manuelilg/eeduro_delta/README.md

# eeduro_delta
A ROS package for the EEDURO Delta Roboter
