manuelilg/eeduro_delta/eeduro_delta_description/cad/fcinfo/base.csv

Info on the element
___________________
07/11/2017 13:07:57
Name of the document : | base_collision
Label Name : | Fusion001
Internal Name : | Fusion001
Name of the element : | Face15
Object type : | Compound
Mouse coordinates : | X: | -74.5734863281 | Y: | 17.348657608 | Z: | 20.0
Length of the object : | 1095.61944902 | mm
Perimeter of the shape : | 5948.85674713 | mm
Vertexes and details : | Edges : | 97 | Faces : | 38 | Vertexes faces : | 192 | Total : | 327
Edge1 | 23.5619445443 | mm | X1 | 86.4951954445 | Y1 | -61.4850740989 | Z1 | -3.97903932026e-13 | X2 | 73.5047992024 | Y2 | -53.9850654554 | Z2 | -2.68229882749e-13
Edge2 | 23.5619450726 | mm | X1 | 73.5047992024 | Y1 | -53.9850654554 | Z1 | -2.68229882749e-13 | X2 | 86.4951954445 | Y2 | -61.4850740989 | Z2 | -3.97903932026e-13
Edge3 | 23.5619449019 | mm | X1 | 86.4951878365 | Y1 | -61.4850697617 | Z1 | 14.0 | X2 | 73.5048067797 | Y2 | -53.9850697617 | Z2 | 14.0
Edge4 | 14.0 | mm | X1 | 86.4951878365 | Y1 | -61.4850697617 | Z1 | 14.0 | X2 | 86.4951954445 | Y2 | -61.4850740989 | Z2 | -3.97903932026e-13
Edge5 | 14.0 | mm | X1 | 73.5048067797 | Y1 | -53.9850697617 | Z1 | 14.0 | X2 | 73.5047992024 | Y2 | -53.9850654554 | Z2 | -2.68229882749e-13
Edge6 | 23.5619449019 | mm | X1 | 73.5048067797 | Y1 | -53.9850697617 | Z1 | 14.0 | X2 | 86.4951878365 | Y2 | -61.4850697617 | Z2 | 14.0
Edge7 | 200.0 | mm | X1 | -115.0 | Y1 | -70.235026919 | Z1 | 14.0 | X2 | -115.0 | Y2 | 129.764973081 | Z2 | 14.0
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
Matrix of inertia : | X: | 7448530703.95 | Y: | -59.306059444 | Z: | -40.7095603448 | : | 0.0
: | X: | -59.306059444 | Y: | 7605678914.8 | Z: | 606902711.949 | : | 0.0
: | X: | -40.7095603448 | Y: | 606902711.949 | Z: | 6841499590.22 | : | 0.0
: | X: | 0.0 | Y: | 0.0 | Z: | 0.0 | : | 1.0
