manuelilg/eeduro_delta/eeduro_delta_description/cad/fcinfo/oberarm/gewindestift_in_x.csv

Info on the element
___________________
07/08/2017 11:11:27
Name of the document : | Unnamed
Label Name : | Arm040
Internal Name : | Part__Feature
Name of the element : | Face7
Object type : | Solid
Mouse coordinates : | X: | -5.96392154694 | Y: | -0.510197639465 | Z: | 2.58369445801
Length of the object : | 3.90111069989 | mm
Perimeter of the shape : | 55.4406874623 | mm
Vertexes and details : | Edges : | 32 | Faces : | 15 | Vertexes faces : | 64 | Total : | 111
Edge1 | 3.92699081699 | mm | X1 | -6.3 | Y1 | -5.0270898555e-13 | Z1 | 1.75 | X2 | -6.3 | Y2 | -5.0270898555e-13 | Z2 | 4.25
Edge2 | 4.6 | mm | X1 | -1.7 | Y1 | -4.47641923529e-13 | Z1 | 1.75 | X2 | -6.3 | Y2 | -5.0270898555e-13 | Z2 | 1.75
Edge3 | 3.92699081699 | mm | X1 | -1.7 | Y1 | -4.47641923529e-13 | Z1 | 1.75 | X2 | -1.7 | Y2 | -4.47641923529e-13 | Z2 | 4.25
Edge4 | 4.6 | mm | X1 | -1.7 | Y1 | -4.47641923529e-13 | Z1 | 4.25 | X2 | -6.3 | Y2 | -5.0270898555e-13 | Z2 | 4.25
Edge5 | 3.92699081699 | mm | X1 | -6.3 | Y1 | -5.0270898555e-13 | Z1 | 4.25 | X2 | -6.3 | Y2 | -5.0270898555e-13 | Z2 | 1.75
Edge6 | 3.92699081699 | mm | X1 | -1.7 | Y1 | -4.47641923529e-13 | Z1 | 4.25 | X2 | -1.7 | Y2 | -4.47641923529e-13 | Z2 | 1.75
Edge7 | 3.29867228627 | mm | X1 | -1.5 | Y1 | -4.68958205602e-13 | Z1 | 1.95 | X2 | -1.5 | Y2 | -4.68958205602e-13 | Z2 | 4.05
Edge8 | 3.29867228627 | mm | X1 | -1.5 | Y1 | -4.68958205602e-13 | Z1 | 4.05 | X2 | -1.5 | Y2 | -4.68958205602e-13 | Z2 | 1.95
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
: | X: | 9.09494701773e-13 | Y: | 51.4983489367 | Z: | 1.09139364213e-11 | : | 0.0
: | X: | 3.63797880709e-12 | Y: | 1.09139364213e-11 | Z: | 51.4983489368 | : | 0.0
: | X: | 0.0 | Y: | 0.0 | Z: | 0.0 | : | 1.0
