manuelilg/eeduro_delta/eeduro_delta_description/cad/fcinfo/oberarm/gleitlager_oben.csv

Info on the element
___________________
07/08/2017 11:10:18
Name of the document      :, Unnamed
Label Name                :, Arm047
Internal Name             :, Part__Feature002
Name of the element       :, Face6
Object type               :, Solid
Mouse coordinates         :,  X:, 48.5765457153,  Y:, -1.76357269287,  Z:, 5.19999694824
Length of the object      :, 29.8451302091, mm
Perimeter of the shape    :, 109.389372261, mm
Vertexes and details      :, Edges :,18, Faces :,9, Vertexes faces :,36, Total :,63
Edge1 , 9.42477796077 , mm,X1 ,  47.4019237886 , Y1 ,  1.5 , Z1 ,  4.4 , X2 ,  52.5980762114 , Y2 ,  -1.5 , Z2 ,  4.4 ,
Edge2 , 2.2 , mm,X1 ,  52.5980762114 , Y1 ,  -1.5 , Z1 ,  4.4 , X2 ,  52.5980762114 , Y2 ,  -1.5 , Z2 ,  2.2 ,
Edge3 , 9.42477796077 , mm,X1 ,  47.4019237886 , Y1 ,  1.5 , Z1 ,  2.2 , X2 ,  52.5980762114 , Y2 ,  -1.5 , Z2 ,  2.2 ,
Edge4 , 2.2 , mm,X1 ,  47.4019237886 , Y1 ,  1.5 , Z1 ,  4.4 , X2 ,  47.4019237886 , Y2 ,  1.5 , Z2 ,  2.2 ,
Edge5 , 9.42477796077 , mm,X1 ,  52.5980762114 , Y1 ,  -1.5 , Z1 ,  4.4 , X2 ,  47.4019237886 , Y2 ,  1.5 , Z2 ,  4.4 ,
Edge6 , 11.780972451 , mm,X1 ,  53.2475952642 , Y1 ,  -1.875 , Z1 ,  4.4 , X2 ,  46.7524047358 , Y2 ,  1.875 , Z2 ,  4.4 ,
Edge7 , 11.780972451 , mm,X1 ,  46.7524047358 , Y1 ,  1.875 , Z1 ,  4.4 , X2 ,  53.2475952642 , Y2 ,  -1.875 , Z2 ,  4.4 ,
Edge8 , 9.42477796077 , mm,X1 ,  52.5980762114 , Y1 ,  -1.5 , Z1 ,  2.2 , X2 ,  47.4019237886 , Y2 ,  1.5 , Z2 ,  2.2 ,
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
                         :, X:, -2.91038304567e-11, Y:, 332.253967021, Z:, -4.36557456851e-11, :, 0.0
                         :, X:, -5.82076609135e-11, Y:, -4.36557456851e-11, Z:, 523.708404092, :, 0.0
                         :, X:, 0.0, Y:, 0.0, Z:, 0.0, :, 1.0
