manuelilg/eeduro_delta/eeduro_delta_description/cad/fcinfo/oberarm/oberarm.csv

Info on the element
___________________
07/08/2017 11:09:25
Name of the document : | Unnamed
Label Name : | Arm053
Internal Name : | Part__Feature004
Name of the element : | Face8
Object type : | Solid
Mouse coordinates : | X: | 0.0 | Y: | 0.0 | Z: | 0.0
Length of the object : | 133.424777961 | mm
Perimeter of the shape : | 473.417577684 | mm
Vertexes and details : | Edges : | 53 | Faces : | 20 | Vertexes faces : | 106 | Total : | 179
Edge1 | 0.288675134595 | mm | X1 | 1.0 | Y1 | 5.8556624327 | Z1 | 3.0 | X2 | 1.25 | Y2 | 6.0 | Z2 | 3.0
Edge2 | 3.92699081699 | mm | X1 | -1.25 | Y1 | 6.0 | Z1 | 3.0 | X2 | 1.25 | Y2 | 6.0 | Z2 | 3.0
Edge3 | 0.288675134595 | mm | X1 | -1.0 | Y1 | 5.8556624327 | Z1 | 3.0 | X2 | -1.25 | Y2 | 6.0 | Z2 | 3.0
Edge4 | 3.14159265359 | mm | X1 | -1.0 | Y1 | 5.8556624327 | Z1 | 3.0 | X2 | 1.0 | Y2 | 5.8556624327 | Z2 | 3.0
Edge5 | 3.92699081699 | mm | X1 | -6.0 | Y1 | -1.25 | Z1 | 3.0 | X2 | -6.0 | Y2 | 1.25 | Z2 | 3.0
Edge6 | 3.92699081699 | mm | X1 | -6.0 | Y1 | 1.25 | Z1 | 3.0 | X2 | -6.0 | Y2 | -1.25 | Z2 | 3.0
Edge7 | 12.0 | mm | X1 | -6.0 | Y1 | 6.0 | Z1 | -9.94759830064e-14 | X2 | -6.0 | Y2 | -6.0 | Z2 | -9.94759830064e-14
Edge8 | 6.0 | mm | X1 | -6.0 | Y1 | -6.0 | Z1 | 6.0 | X2 | -6.0 | Y2 | -6.0 | Z2 | -9.94759830064e-14
Edge9 | 12.0 | mm | X1 | -6.0 | Y1 | -6.0 | Z1 | 6.0 | X2 | -6.0 | Y2 | 6.0 | Z2 | 6.0
Edge10 | 6.0 | mm | X1 | -6.0 | Y1 | 6.0 | Z1 | 6.0 | X2 | -6.0 | Y2 | 6.0 | Z2 | -9.94759830064e-14
Edge11 | 60.0 | mm | X1 | -6.0 | Y1 | -6.0 | Z1 | -9.94759830064e-14 | X2 | 54.0 | Y2 | -6.0 | Z2 | -1.27897692437e-13
Edge12 | 4.4 | mm | X1 | 54.0 | Y1 | -6.0 | Z1 | 4.4 | X2 | 54.0 | Y2 | -6.0 | Z2 | -1.27897692437e-13
Edge13 | 10.0 | mm | X1 | 54.0 | Y1 | -6.0 | Z1 | 4.4 | X2 | 44.0 | Y2 | -6.0 | Z2 | 4.4
Edge14 | 1.6 | mm | X1 | 44.0 | Y1 | -6.0 | Z1 | 4.4 | X2 | 44.0 | Y2 | -6.0 | Z2 | 6.0
Edge15 | 50.0 | mm | X1 | 44.0 | Y1 | -6.0 | Z1 | 6.0 | X2 | -6.0 | Y2 | -6.0 | Z2 | 6.0
Edge16 | 4.4 | mm | X1 | 52.5980762114 | Y1 | 1.5 | Z1 | -1.13686837722e-13 | X2 | 52.5980762114 | Y2 | 1.5 | Z2 | 4.4
Edge17 | 9.42477796077 | mm | X1 | 47.4019237886 | Y1 | -1.5 | Z1 | 4.4 | X2 | 52.5980762114 | Y2 | 1.5 | Z2 | 4.4
Edge18 | 4.4 | mm | X1 | 47.4019237886 | Y1 | -1.5 | Z1 | -1.27897692437e-13 | X2 | 47.4019237886 | Y2 | -1.5 | Z2 | 4.4
Edge19 | 9.42477796077 | mm | X1 | 47.4019237886 | Y1 | -1.5 | Z1 | -1.27897692437e-13 | X2 | 52.5980762114 | Y2 | 1.5 | Z2 | -1.13686837722e-13
Edge20 | 4.4 | mm | X1 | 54.0 | Y1 | 6.0 | Z1 | 4.4 | X2 | 54.0 | Y2 | 6.0 | Z2 | -1.13686837722e-13
Edge21 | 60.0 | mm | X1 | 54.0 | Y1 | 6.0 | Z1 | -1.13686837722e-13 | X2 | -6.0 | Y2 | 6.0 | Z2 | -9.94759830064e-14
Edge22 | 50.0 | mm | X1 | 44.0 | Y1 | 6.0 | Z1 | 6.0 | X2 | -6.0 | Y2 | 6.0 | Z2 | 6.0
Edge23 | 1.6 | mm | X1 | 44.0 | Y1 | 6.0 | Z1 | 6.0 | X2 | 44.0 | Y2 | 6.0 | Z2 | 4.4
Edge24 | 10.0 | mm | X1 | 44.0 | Y1 | 6.0 | Z1 | 4.4 | X2 | 54.0 | Y2 | 6.0 | Z2 | 4.4
Edge25 | 3.92699081699 | mm | X1 | 1.25 | Y1 | 6.0 | Z1 | 3.0 | X2 | -1.25 | Y2 | 6.0 | Z2 | 3.0
Edge26 | 12.0 | mm | X1 | 54.0 | Y1 | -6.0 | Z1 | -1.27897692437e-13 | X2 | 54.0 | Y2 | 6.0 | Z2 | -1.13686837722e-13
Edge27 | 12.0 | mm | X1 | 54.0 | Y1 | 6.0 | Z1 | 4.4 | X2 | 54.0 | Y2 | -6.0 | Z2 | 4.4
Edge28 | 4.73762844395 | mm | X1 | 1.0 | Y1 | 1.11803398875 | Z1 | 3.0 | X2 | 1.0 | Y2 | 5.8556624327 | Z2 | 3.0
Edge29 | 4.73762844395 | mm | X1 | -1.0 | Y1 | 1.11803398875 | Z1 | 3.0 | X2 | -1.0 | Y2 | 5.8556624327 | Z2 | 3.0
Edge30 | 3.25301876623 | mm | X1 | -1.0 | Y1 | 1.11803398875 | Z1 | 3.0 | X2 | 1.0 | Y2 | 1.11803398875 | Z2 | 3.0
Edge31 | 12.0 | mm | X1 | 44.0 | Y1 | 6.0 | Z1 | 6.0 | X2 | 44.0 | Y2 | -6.0 | Z2 | 6.0
Edge32 | 4.71238898038 | mm | X1 | -1.29903810568 | Y1 | -0.75 | Z1 | 6.0 | X2 | 1.29903810568 | Y2 | 0.75 | Z2 | 6.0
Edge33 | 4.71238898038 | mm | X1 | 1.29903810568 | Y1 | 0.75 | Z1 | 6.0 | X2 | -1.29903810568 | Y2 | -0.75 | Z2 | 6.0
Edge34 | 9.42477796077 | mm | X1 | 52.5980762114 | Y1 | 1.5 | Z1 | -1.13686837722e-13 | X2 | 47.4019237886 | Y2 | -1.5 | Z2 | -1.27897692437e-13
Edge35 | 4.71238898038 | mm | X1 | -1.29903810568 | Y1 | -0.75 | Z1 | 0.0 | X2 | 1.29903810568 | Y2 | 0.75 | Z2 | -9.94759830064e-14
Edge36 | 4.71238898038 | mm | X1 | 1.29903810568 | Y1 | 0.75 | Z1 | -9.94759830064e-14 | X2 | -1.29903810568 | Y2 | -0.75 | Z2 | 0.0
Edge37 | 4.73762844395 | mm | X1 | -1.11803398875 | Y1 | -1.0 | Z1 | 3.0 | X2 | -5.8556624327 | Y2 | -1.0 | Z2 | 3.0
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
Surface of the face : | 592.931416529 | mm²
Volume of the form : | 3932.10358546 | mm³
Weight : | 29.4907768909 | g | Density: | 7.5
Center of the shape : | X: | 24.0 | Y: | -4.4320103143e-13 | Z: | 3.0
Center of mass : | X: | 22.4067809439 | Y: | -0.0137682789554 | Z: | 2.91788763221
BoundBox : | X: | 60.0 | mm | Y: | 12.0 | mm | Z: | 6.0 | mm
Matrix of inertia : | X: | 60548.5436791 | Y: | -1213.06393042 | Z: | 8486.74273093 | : | 0.0
: | X: | -1213.06393042 | Y: | 1047556.61565 | Z: | 4.4453725724 | : | 0.0
: | X: | 8486.74273093 | Y: | 4.4453725724 | Z: | 1085008.40434 | : | 0.0
: | X: | 0.0 | Y: | 0.0 | Z: | 0.0 | : | 1.0
