manuelilg/eeduro_delta/eeduro_delta_description/cad/fcstd/tool.fcstd

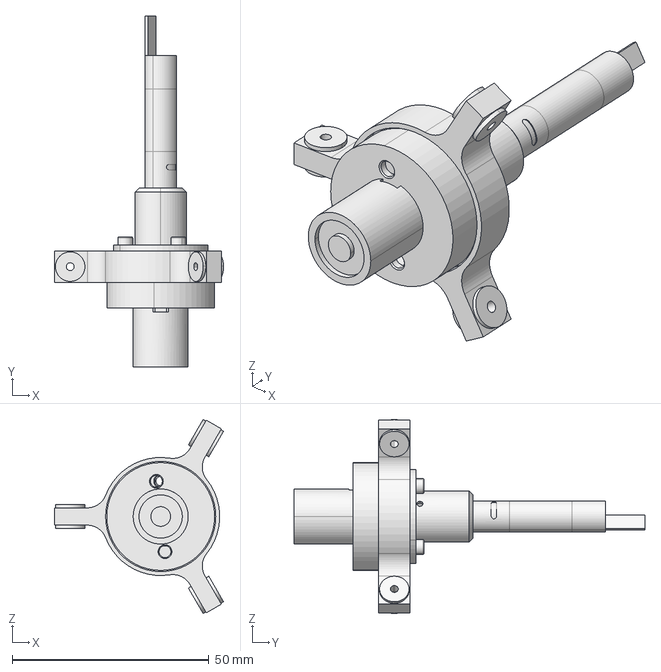
[picture p1: CAD file, 2017-07-11]
eeduro_delta_description/cad/fcstd/tool.fcstd
43.0 x 89.2 x 49.3 mm
