manuelilg/eeduro_delta/eeduro_delta_description/cad/step/D005_Distanzrohr.stp

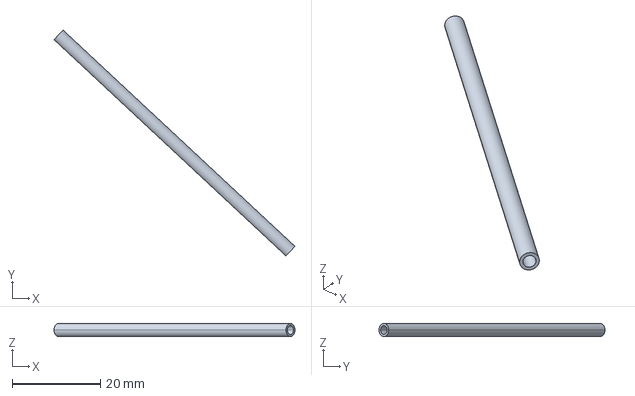
[picture p2: CAD file, 2017-07-10]
eeduro_delta_description/cad/step/D005_Distanzrohr.stp
54.7 x 51.3 x 3.00 mm
