manuelilg/eeduro_delta/eeduro_delta_description/cad/fcstd/gelenkstange.fcstd

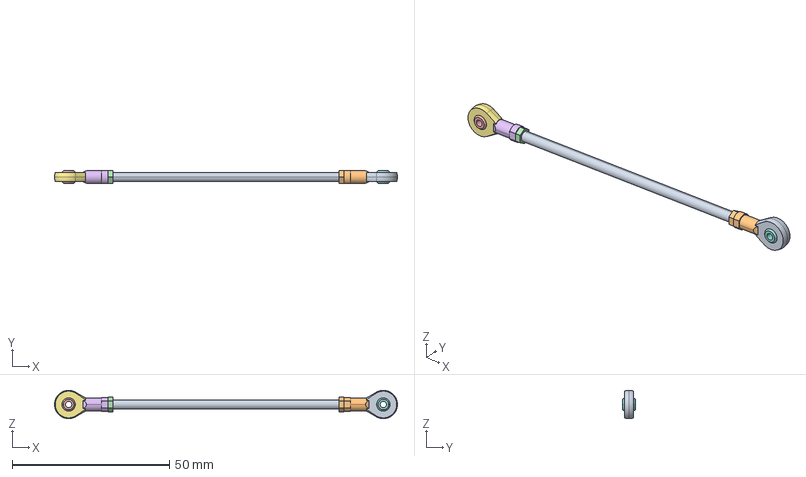
[picture p3: CAD file, 2017-07-11]
eeduro_delta_description/cad/fcstd/gelenkstange.fcstd
109.0 x 4.00 x 9.00 mm
Gewindearm031
Gewindearm033
Gewindearm034
Gewindearm032
