manuelilg/eeduro_delta/eeduro_delta_description/cad/step/D009_WZ_Flansch.stp

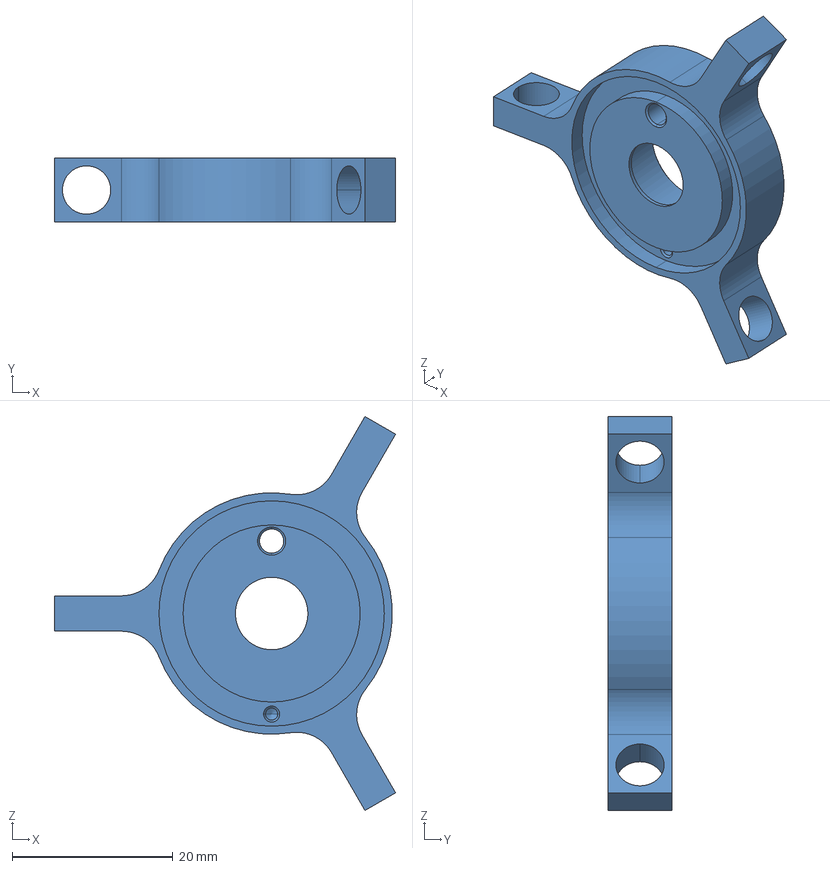
[picture p4: CAD file, 2017-07-10]
eeduro_delta_description/cad/step/D009_WZ_Flansch.stp
42.4 x 8.00 x 49.0 mm
