manuelilg/eeduro_delta/eeduro_delta_description/cad/fcstd/Gelenkkopf_KBRM_02.fcstd

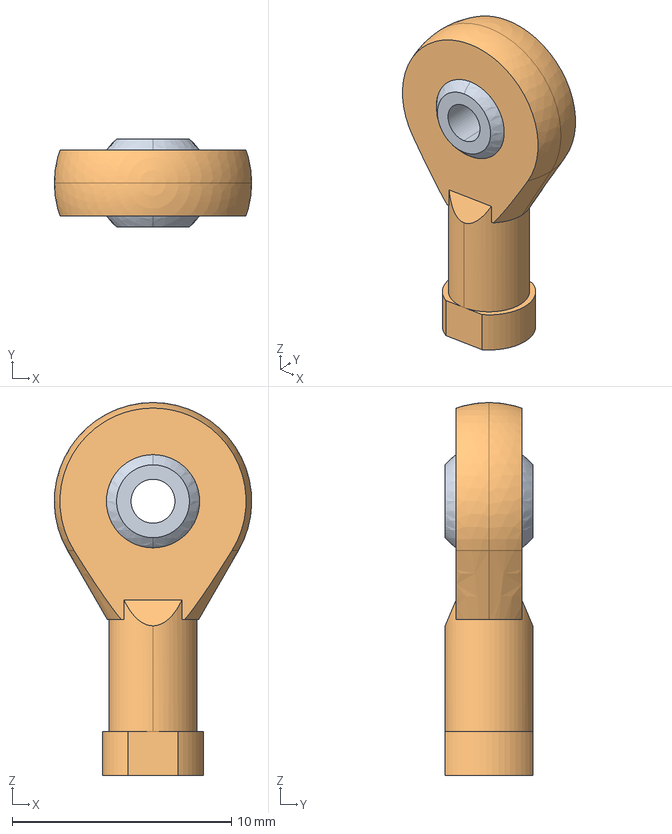
[picture p5: CAD file, 2017-07-11]
eeduro_delta_description/cad/fcstd/Gelenkkopf_KBRM_02.fcstd
9.00 x 4.00 x 17.0 mm
