manuelilg/eeduro_delta/eeduro_delta_description/cad/step/D003_Oberarm.stp

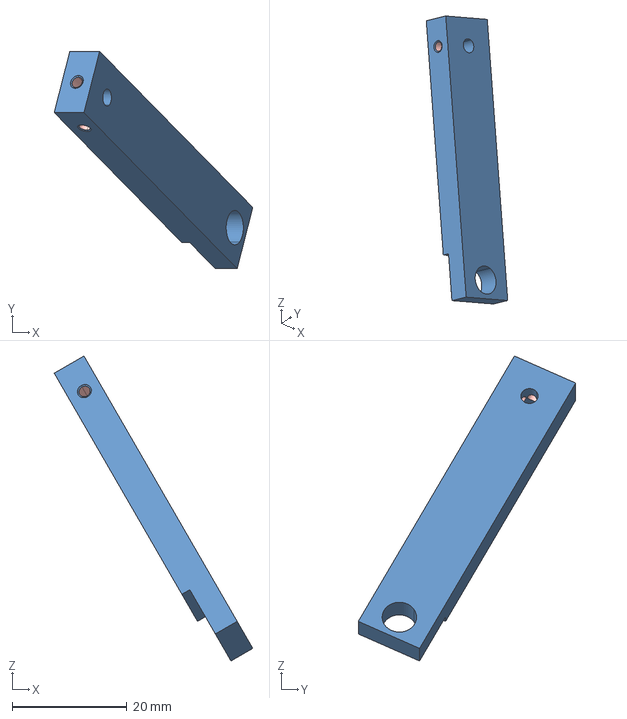
[picture p6: CAD file, 2017-07-10]
eeduro_delta_description/cad/step/D003_Oberarm.stp
34.7 x 37.9 x 53.2 mm
