manuelilg/eeduro_delta/eeduro_delta_description/cad/fcstd/gelenk.fcstd

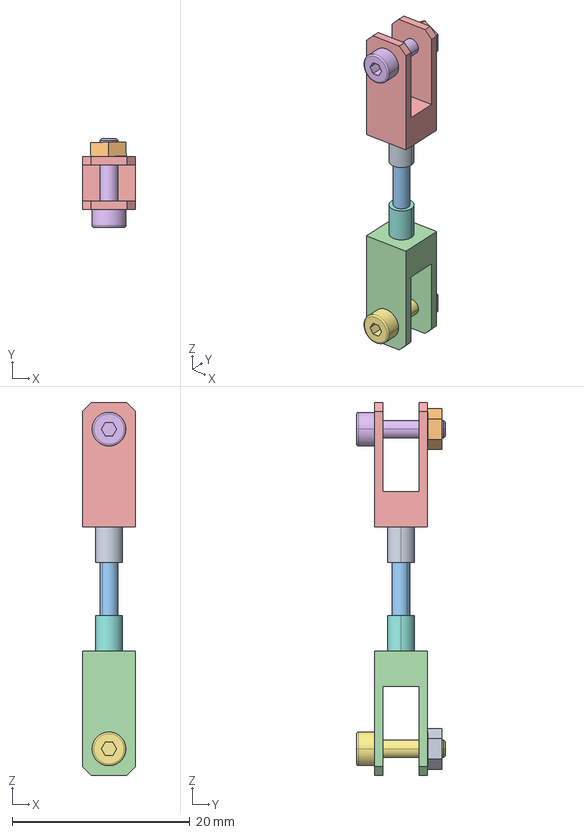
[picture p7: CAD file, 2017-07-10]
eeduro_delta_description/cad/fcstd/gelenk.fcstd
6.00 x 10.0 x 42.0 mm
Gewindearm030
Gewindearm029
Gewindearm027
Arm052
Arm051
Arm043
Arm042
Arm039
Arm038
