manuelilg/eeduro_delta/eeduro_delta_description/cad/fcstd/oberarm.fcstd

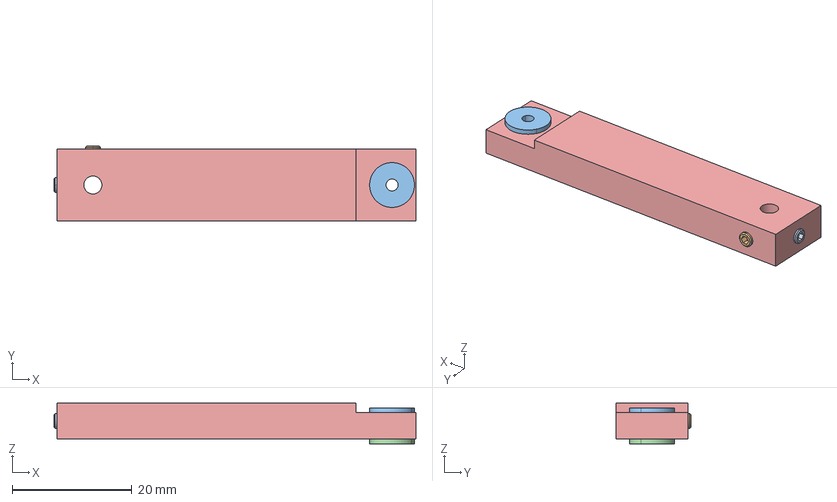
[picture p9: CAD file, 2017-07-10]
eeduro_delta_description/cad/fcstd/oberarm.fcstd
60.5 x 12.5 x 6.80 mm
Arm040
Arm041
Arm047
Arm048
Arm053
