manuelilg/eeduro_delta/eeduro_delta_description/cad/step/D004_Distanzhülse_klein.stp

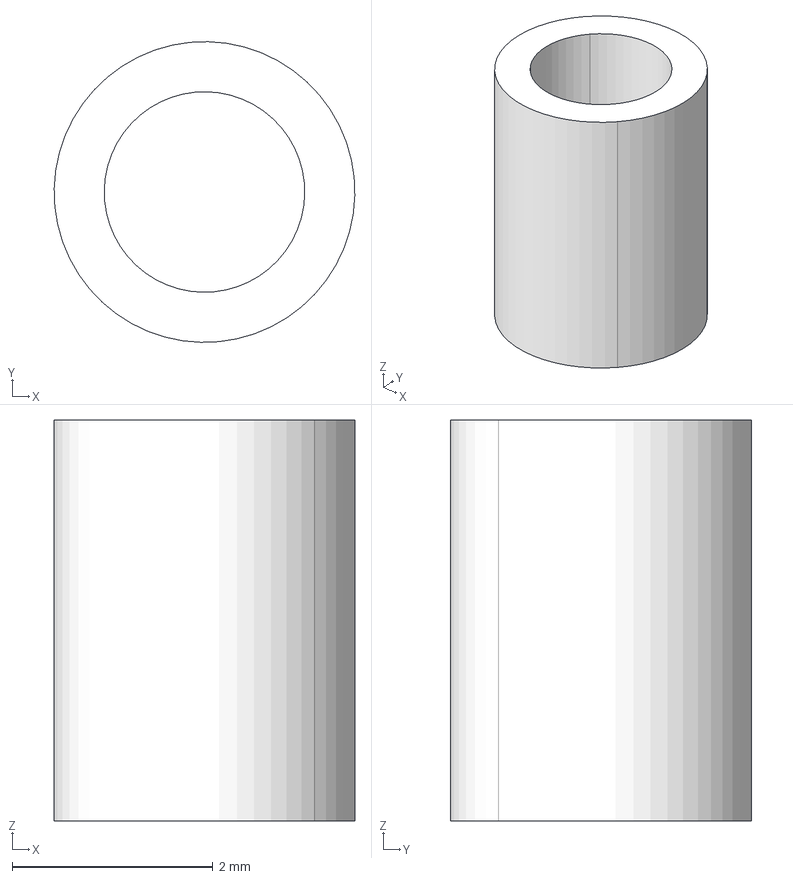
[picture p10: CAD file, 2017-07-10]
eeduro_delta_description/cad/step/D004_Distanzhülse_klein.stp
3.00 x 3.00 x 4.00 mm
