manuelilg/eeduro_delta/eeduro_delta_description/cad/step/D006_Gewindestange_kurz.stp

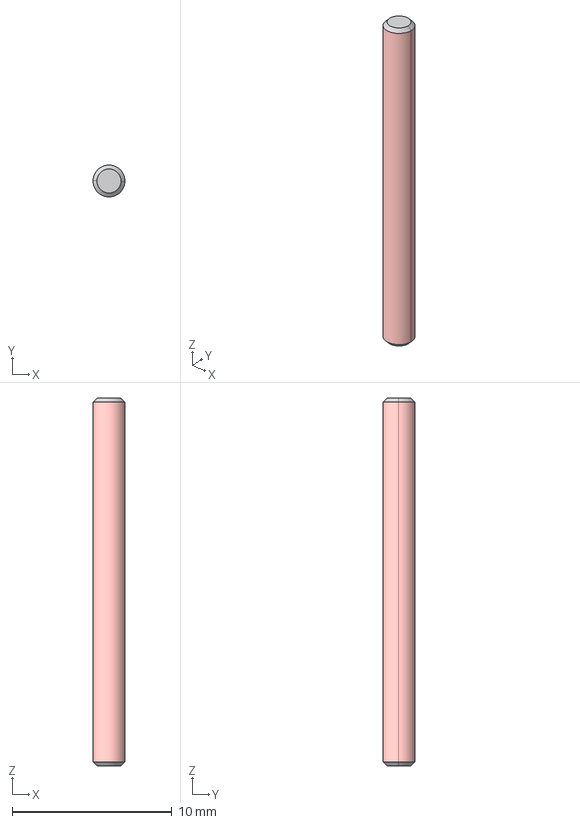
[picture p11: CAD file, 2017-07-10]
eeduro_delta_description/cad/step/D006_Gewindestange_kurz.stp
2.00 x 2.00 x 23.0 mm
