manuelilg/eeduro_delta/eeduro_delta_description/cad/step/D007_Gewindestange_lang.stp

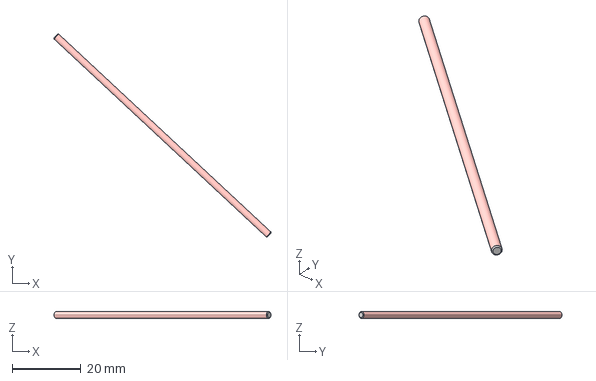
[picture p12: CAD file, 2017-07-10]
eeduro_delta_description/cad/step/D007_Gewindestange_lang.stp
63.2 x 59.1 x 2.00 mm
