manuelilg/eeduro_delta/eeduro_delta_description/cad/step/D008_Stütze.stp

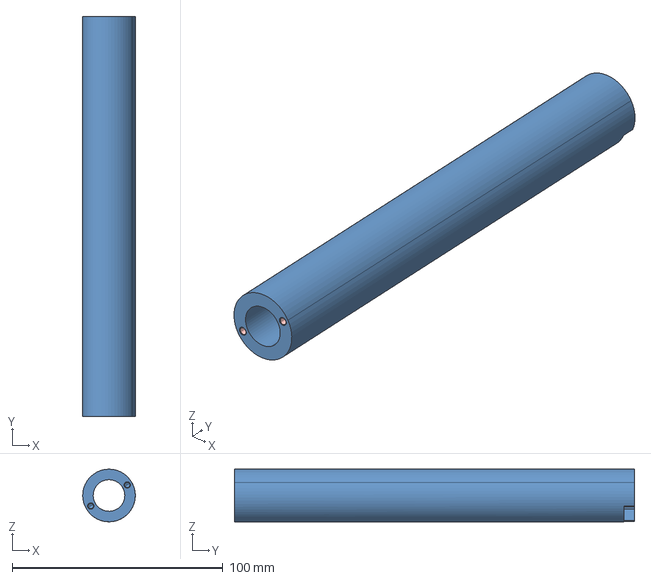
[picture p13: CAD file, 2017-07-10]
eeduro_delta_description/cad/step/D008_Stütze.stp
25.0 x 190.0 x 25.0 mm
