manuelilg/eeduro_delta/eeduro_delta_description/cad/step/D021_Gabelkopf.stp

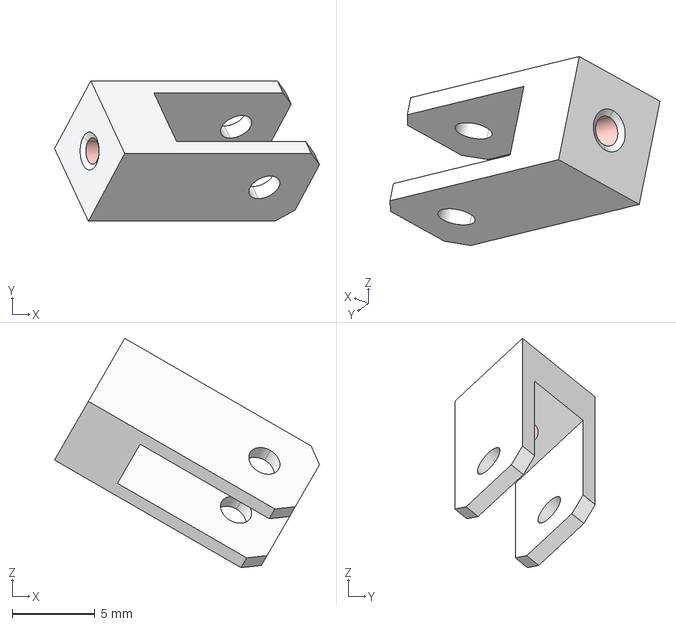
[picture p14: CAD file, 2017-07-10]
eeduro_delta_description/cad/step/D021_Gabelkopf.stp
16.0 x 8.48 x 13.8 mm
