manuelilg/eeduro_delta/eeduro_delta_joint_state_publisher/include/eeduro_delta_joint_state_publisher/TypeDefs.hpp

/*
 * TypeDefs.hpp
 *
 *  Created on: Jul 20, 2017
 *      Author: manuel
 */

#pragma once

#include <Eigen/Core>

namespace delta_kinematic {

	typedef Eigen::Vector3d Vector;
	typedef Eigen::Vector3d Position;
	typedef Eigen::AngleAxisd RotMatrix;


}  // namespace delta_kinematic
