manuelilg/eeduro_delta/(commit log)

2017-07-10 added mass and inertia callculations
    [D000_EEROS_Deltaroboter.stp, D003_Oberarm.stp, D004_Distanzhülse_klein.stp, D005_Distanzrohr.stp, D006_Gewindestange_kurz.stp, D007_Gewindestange_lang.stp, D008_Stütze.stp, D009_WZ_Flansch.stp]
2017-07-11 finished mass and inertia calculations
    [Gelenkkopf_KBRM_02.csv, Gelenkkopf_KBRM_02.fcstd, eeduro_delta_inertias.ods, gewindestange.csv, lager.csv, lager_gross.csv]
2017-07-11 worked on urdf
    [base.csv, eeduro_delta.urdf, glenkstange_v2.fcstd]
2017-07-11 added damping to joints
    [eeduro_delta.urdf]
2017-07-11 finihed arm1 in urdf
    [eeduro_delta.urdf, tool.fcstd]
2017-07-12 started with xacro implementation
    [eeduro_delta.urdf.xacro, eeduro_delta_inertial.urdf.xacro]
2017-07-13 some changes in table
    [eeduro_delta_inertias.ods]
2017-07-13 xacro: added macro for arm (only motor in macro)
    [eeduro_delta.urdf.xacro, eeduro_delta_inertial.urdf.xacro]
2017-07-13 xacro: arm modeled till joint3
    [eeduro_delta.urdf.xacro, eeduro_delta_inertial.urdf.xacro]
2017-07-13 xacro: added link4 and joints to close kinematic chain
    [eeduro_delta.urdf.xacro, eeduro_delta_inertial.urdf.xacro]
2017-07-13 xacro: added tool
    [eeduro_delta.urdf.xacro, eeduro_delta_inertial.urdf.xacro]
2017-07-13 xacro: replaced hard coded angles with expressions
    [eeduro_delta.urdf.xacro, eeduro_delta_inertial.urdf.xacro]
2017-07-13 xacro: move angle definition to macro input
    [eeduro_delta.urdf.xacro]
2017-07-13 tool exactly in middle of robot
    [eeduro_delta.urdf.xacro]
2017-07-13 changed how poition and orientation for arm is defined
    [eeduro_delta.urdf.xacro]
2017-07-13 xacro: added arm2 and arm3, some bug-fixes for sdf-joints
    [eeduro_delta.urdf.xacro]
2017-07-13 renamed old urdf-file
    [eeduro_delta_old.urdf]
2017-07-13 inertial-file rearanged content
    [eeduro_delta_inertial.urdf.xacro]
2017-07-13 remov not used sdf-file
    [delta.sdf]
2017-07-13 ensure that float division is used
    [eeduro_delta.urdf.xacro]
2017-07-18 added mimic tags in urdf
    [eeduro_delta.urdf.xacro]
2017-07-18 started with joint_state_publisher
2017-07-20 move joint_state_publisher into own package
2017-07-20 DeltaKinematic added (only gear transmission is calculated)
2017-07-22 forwad Kinematik finished, without publishing
2017-07-22 bugfixes in joint_state_publisher
2017-07-22 remove debug outputs in joint_state_publisher
2017-08-08 add joint state publisher to urdf
    [eeduro_delta.urdf.xacro]
2017-08-08 modify eeduro joint state publisher due to bug in gazebo
    [DeltaKinematic.cpp, EEDuroDeltaJointStatePublisher.cpp]
2017-08-08 change initial position
    [eeduro_delta.urdf.xacro]
2017-08-08 adjust joint_state_publisher for new inital position
    [eeduro_delta.urdf.xacro]
2017-09-08 remove old cad data
    [glenk1.fcstd, glenkstange.fcstd]
2017-09-08 rename cad file
    [gelenkstange.fcstd]
2017-09-08 add collision to link1 and link2
    [eeduro_delta.urdf.xacro]
